carrola1/Ethan_Toy_RevB/Space_Toy_KiCAD/Space_Toy.kicad_pcb

## KiCad design Space_Toy_KiCAD/Space_Toy.kicad_pcb (2017-09-21)

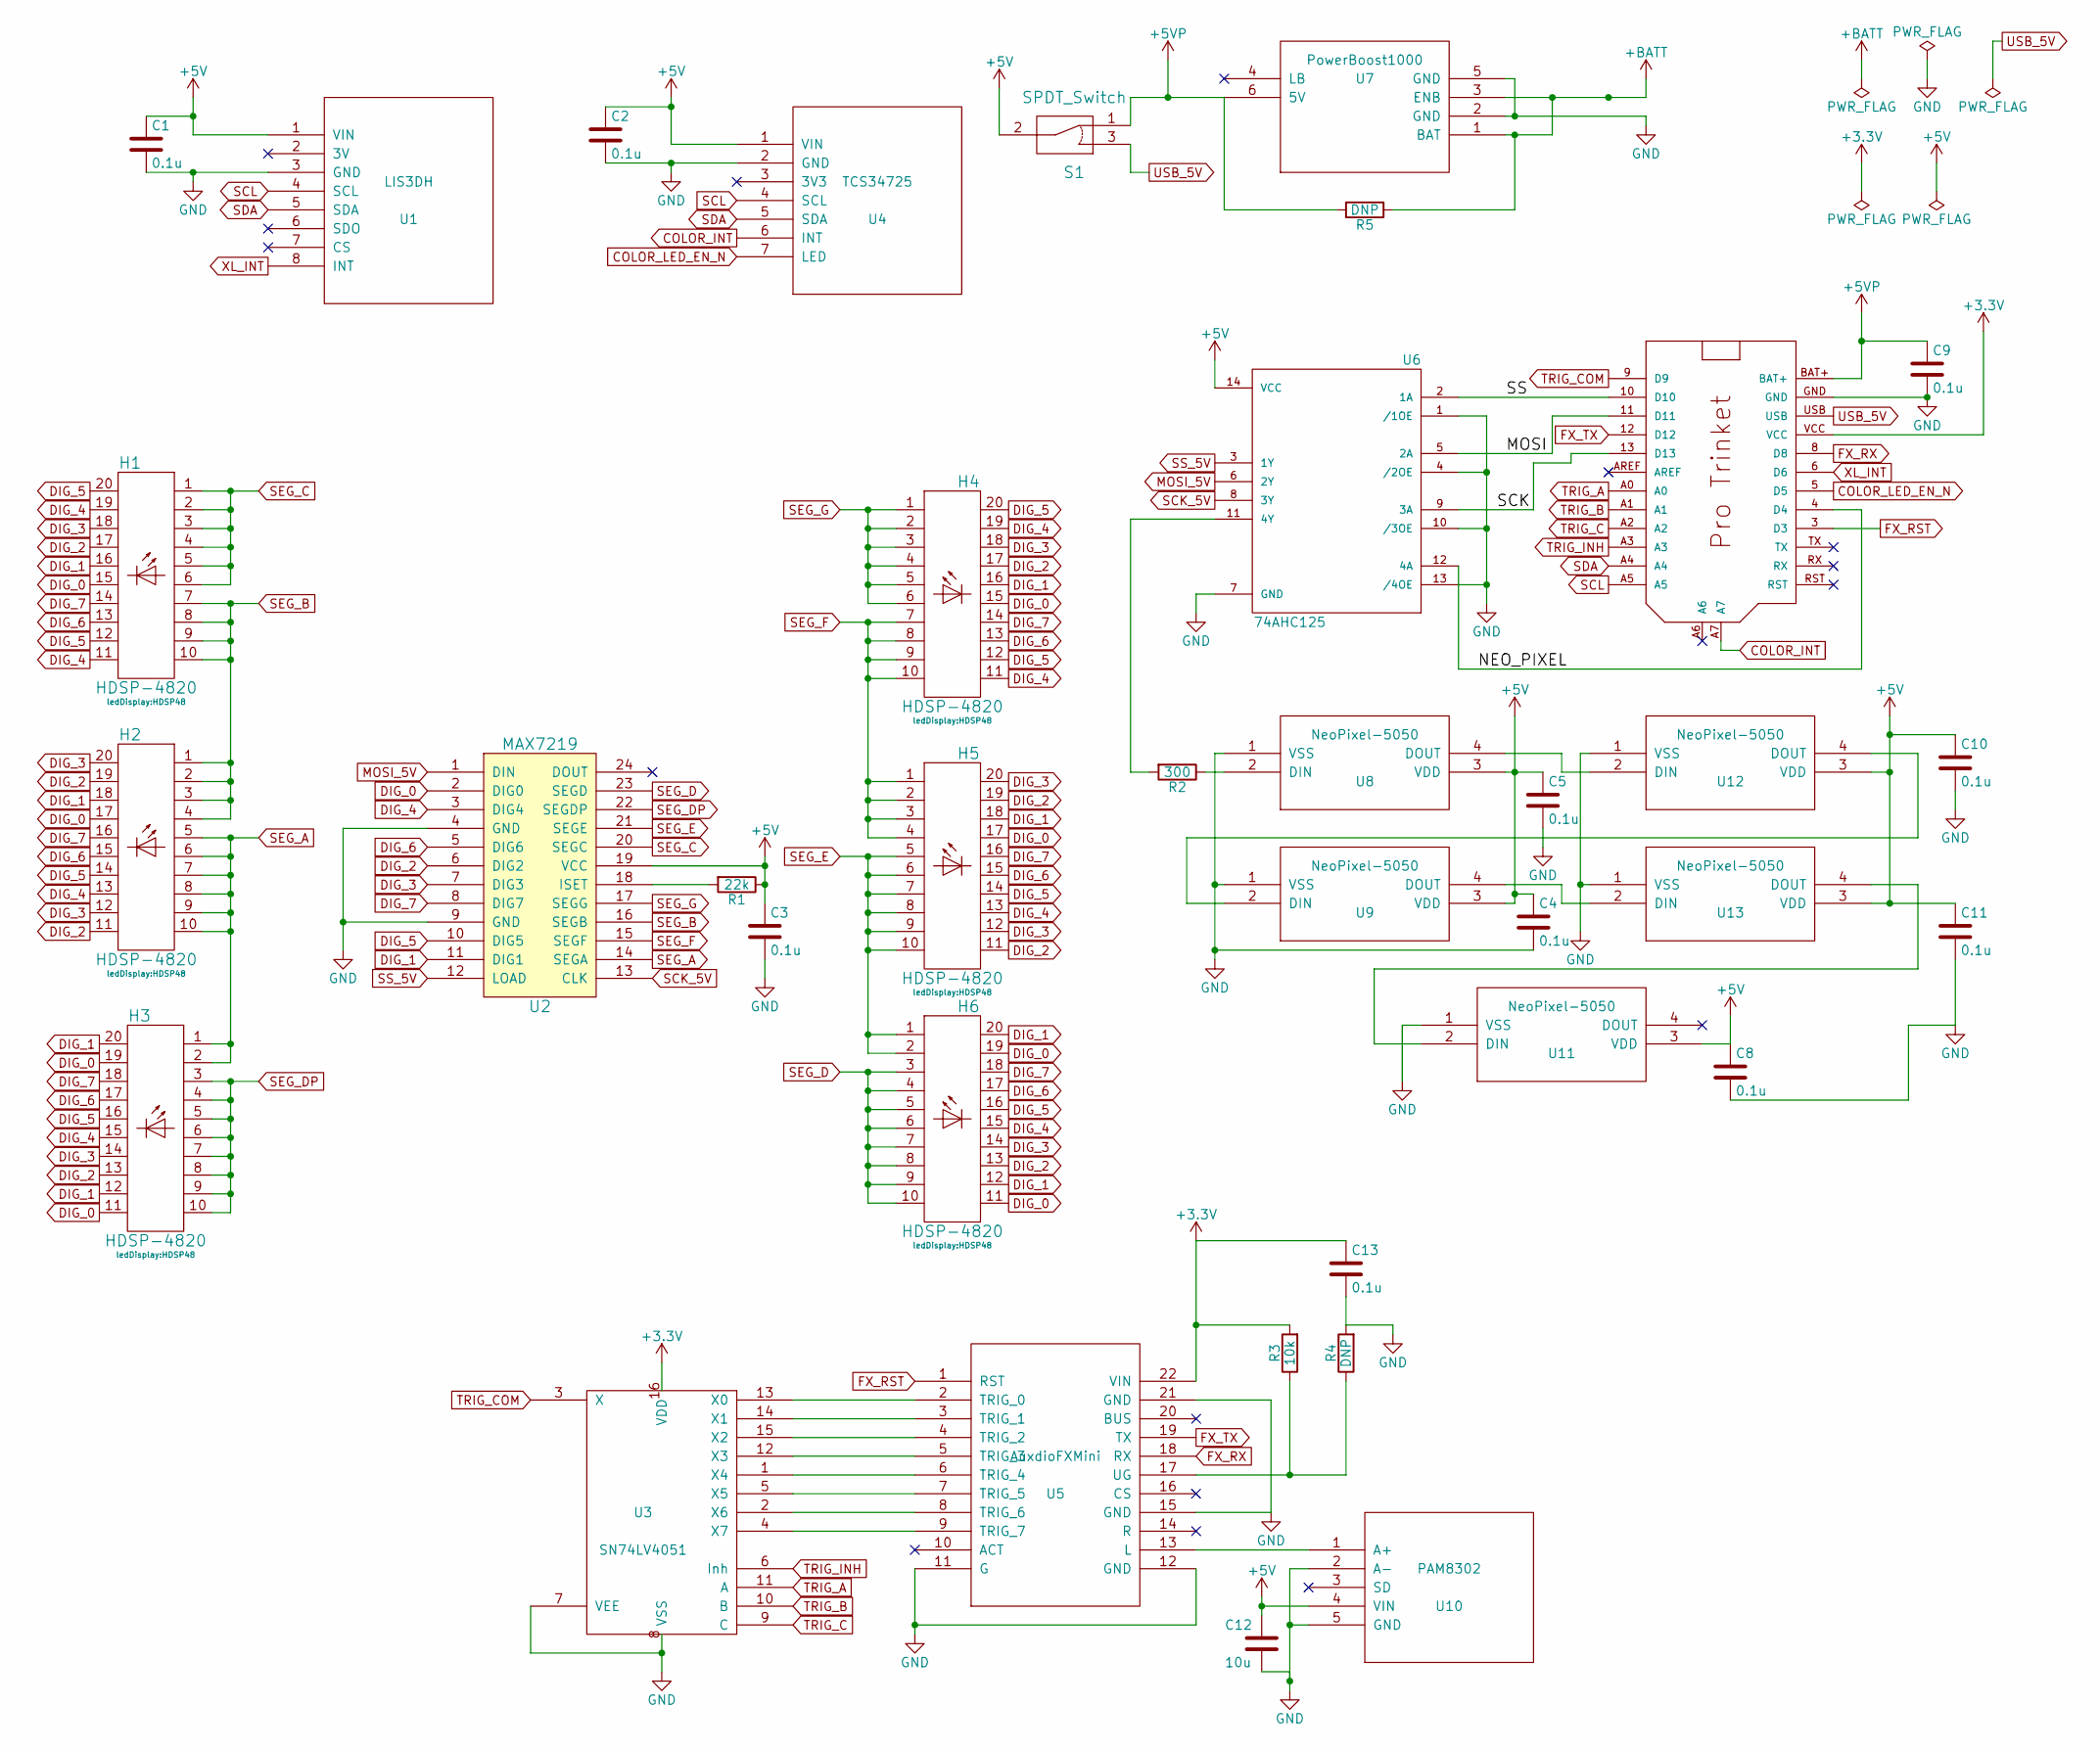
[picture p1: schematic Space_Toy.sch]

Parts:
C1, C2, C3, C4, C5, C8, C9, C10, C11, C13: 0.1u; C_0603_HandSoldering
C12: 10u; C_0603_HandSoldering
H1, H2, H3, H4, H5, H6: HDSP-4820; HDSP48
M1: PRO_TRINKET; PROTRINKET
R1: 22k; R_0805_HandSoldering
R2: 300; R_0805_HandSoldering
R3: 10k; R_0805_HandSoldering
R4, R5: DNP; R_0805_HandSoldering
S1: SPDT_Switch; SPDT
U1: LIS3DH
U2: MAX7219; DIP-24_W7.62mm_LongPads
U3: SN74LV4051; DIP-16_W7.62mm_LongPads
U4: TCS34725
U5: AuxdioFXMini; AudioFXMini
U6: 74AHC125; DIP-14_W7.62mm_LongPads
U7: PowerBoost1000
U8, U9, U11, U12, U13: NeoPixel-5050; NeoPixel5050
U10: PAM8302

Connections:
+3V3: C13.1, M1.VCC, R3.2, U3.16 (VDD), U5.22 (VIN)
+5V: C1.1, C2.1, C3.1, C4.1, C5.1, C8.1, C10.1, C11.1, C12.1, R1.1, S1.2, U1.1 (VIN), U2.19 (VCC), U4.1 (VIN), U6.14 (VCC), U8.3 (VDD), U9.3 (VDD), U10.4 (VIN), U11.3 (VDD), U12.3 (VDD), U13.3 (VDD)
+5VP: C9.1, M1.BAT+, R5.2, S1.1, U7.6 (5V)
+BATT: R5.1, U7.1 (BAT), U7.3 (ENB)
/MOSI: M1.11 (D11), U6.5 (2A)
/NEO_PIXEL: M1.4 (D4), U6.12 (4A)
/SCK: M1.13 (D13), U6.9 (3A)
/SS: M1.10 (D10), U6.2 (1A)
COLOR_INT: M1.A7, U4.6 (INT)
COLOR_LED_EN_N: M1.5 (D5), U4.7 (LED)
DIG_0: H1.15 (K), H2.17 (K), H3.11 (K), H3.19 (K), H4.15 (K), H5.17 (K), H6.11 (K), H6.19 (K), U2.2 (DIG0)
DIG_1: H1.16 (K), H2.18 (K), H3.12 (K), H3.20 (K), H4.16 (K), H5.18 (K), H6.12 (K), H6.20 (K), U2.11 (DIG1)
DIG_2: H1.17 (K), H2.11 (K), H2.19 (K), H3.13 (K), H4.17 (K), H5.11 (K), H5.19 (K), H6.13 (K), U2.6 (DIG2)
DIG_3: H1.18 (K), H2.12 (K), H2.20 (K), H3.14 (K), H4.18 (K), H5.12 (K), H5.20 (K), H6.14 (K), U2.7 (DIG3)
DIG_4: H1.11 (K), H1.19 (K), H2.13 (K), H3.15 (K), H4.11 (K), H4.19 (K), H5.13 (K), H6.15 (K), U2.3 (DIG4)
DIG_5: H1.12 (K), H1.20 (K), H2.14 (K), H3.16 (K), H4.12 (K), H4.20 (K), H5.14 (K), H6.16 (K), U2.10 (DIG5)
DIG_6: H1.13 (K), H2.15 (K), H3.17 (K), H4.13 (K), H5.15 (K), H6.17 (K), U2.5 (DIG6)
DIG_7: H1.14 (K), H2.16 (K), H3.18 (K), H4.14 (K), H5.16 (K), H6.18 (K), U2.8 (DIG7)
FX_RST: M1.3 (D3), U5.1 (RST)
FX_RX: M1.8 (D8), U5.18 (RX)
FX_TX: M1.12 (D12), U5.19 (TX)
GND: C1.2, C2.2, C3.2, C4.2, C5.2, C8.2, C9.2, C10.2, C11.2, C12.2, C13.2, M1.GND, R4.2, U1.3 (GND), U2.4 (GND), U2.9 (GND), U3.7 (VEE), U3.8 (VSS), U4.2 (GND), U5.11 (G), U5.12 (GND), U5.15 (GND), U5.21 (GND), U6.1 (/1OE), U6.4 (/2OE), U6.7 (GND), U6.10 (/3OE), U6.13 (/4OE), U7.2 (GND), U7.5 (GND), U8.1 (VSS), U9.1 (VSS), U10.2 (A-), U10.5 (GND), U11.1 (VSS), U12.1 (VSS), U13.1 (VSS)
MOSI_5V: U2.1 (DIN), U6.6 (2Y)
unnamed: R1.2, U2.18 (ISET)
unnamed: R2.1, U8.2 (DIN)
unnamed: R2.2, U6.11 (4Y)
unnamed: R3.1, R4.1, U5.17 (UG)
unnamed: U3.1 (X4), U5.6 (TRIG_4)
unnamed: U3.2 (X6), U5.8 (TRIG_6)
unnamed: U3.4 (X7), U5.9 (TRIG_7)
unnamed: U3.5 (X5), U5.7 (TRIG_5)
unnamed: U3.12 (X3), U5.5 (TRIG_3)
unnamed: U3.13 (X0), U5.2 (TRIG_0)
unnamed: U3.14 (X1), U5.3 (TRIG_1)
unnamed: U3.15 (X2), U5.4 (TRIG_2)
unnamed: U5.13 (L), U10.1 (A+)
unnamed: U11.2 (DIN), U13.4 (DOUT)
unnamed: U8.4 (DOUT), U12.2 (DIN)
unnamed: U9.2 (DIN), U12.4 (DOUT)
unnamed: U9.4 (DOUT), U13.2 (DIN)
SCK_5V: U2.13 (CLK), U6.8 (3Y)
SCL: M1.A5, U1.4 (SCL), U4.4 (SCL)
SDA: M1.A4, U1.5 (SDA), U4.5 (SDA)
SEG_A: H2.5 (A), H2.6 (A), H2.7 (A), H2.8 (A), H2.9 (A), H2.10 (A), H3.1 (A), H3.2 (A), U2.14 (SEGA)
SEG_B: H1.7 (A), H1.8 (A), H1.9 (A), H1.10 (A), H2.1 (A), H2.2 (A), H2.3 (A), H2.4 (A), U2.16 (SEGB)
SEG_C: H1.1 (A), H1.2 (A), H1.3 (A), H1.4 (A), H1.5 (A), H1.6 (A), U2.20 (SEGC)
SEG_D: H6.3 (A), H6.4 (A), H6.5 (A), H6.6 (A), H6.7 (A), H6.8 (A), H6.9 (A), H6.10 (A), U2.23 (SEGD)
SEG_DP: H3.3 (A), H3.4 (A), H3.5 (A), H3.6 (A), H3.7 (A), H3.8 (A), H3.9 (A), H3.10 (A), U2.22 (SEGDP)
SEG_E: H5.5 (A), H5.6 (A), H5.7 (A), H5.8 (A), H5.9 (A), H5.10 (A), H6.1 (A), H6.2 (A), U2.21 (SEGE)
SEG_F: H4.7 (A), H4.8 (A), H4.9 (A), H4.10 (A), H5.1 (A), H5.2 (A), H5.3 (A), H5.4 (A), U2.15 (SEGF)
SEG_G: H4.1 (A), H4.2 (A), H4.3 (A), H4.4 (A), H4.5 (A), H4.6 (A), U2.17 (SEGG)
SS_5V: U2.12 (LOAD), U6.3 (1Y)
TRIG_A: M1.A0, U3.11 (A)
TRIG_B: M1.A1, U3.10 (B)
TRIG_C: M1.A2, U3.9 (C)
TRIG_COM: M1.9 (D9), U3.3 (X)
TRIG_INH: M1.A3, U3.6 (Inh)
USB_5V: M1.USB, S1.3
XL_INT: M1.6 (D6), U1.8 (INT)

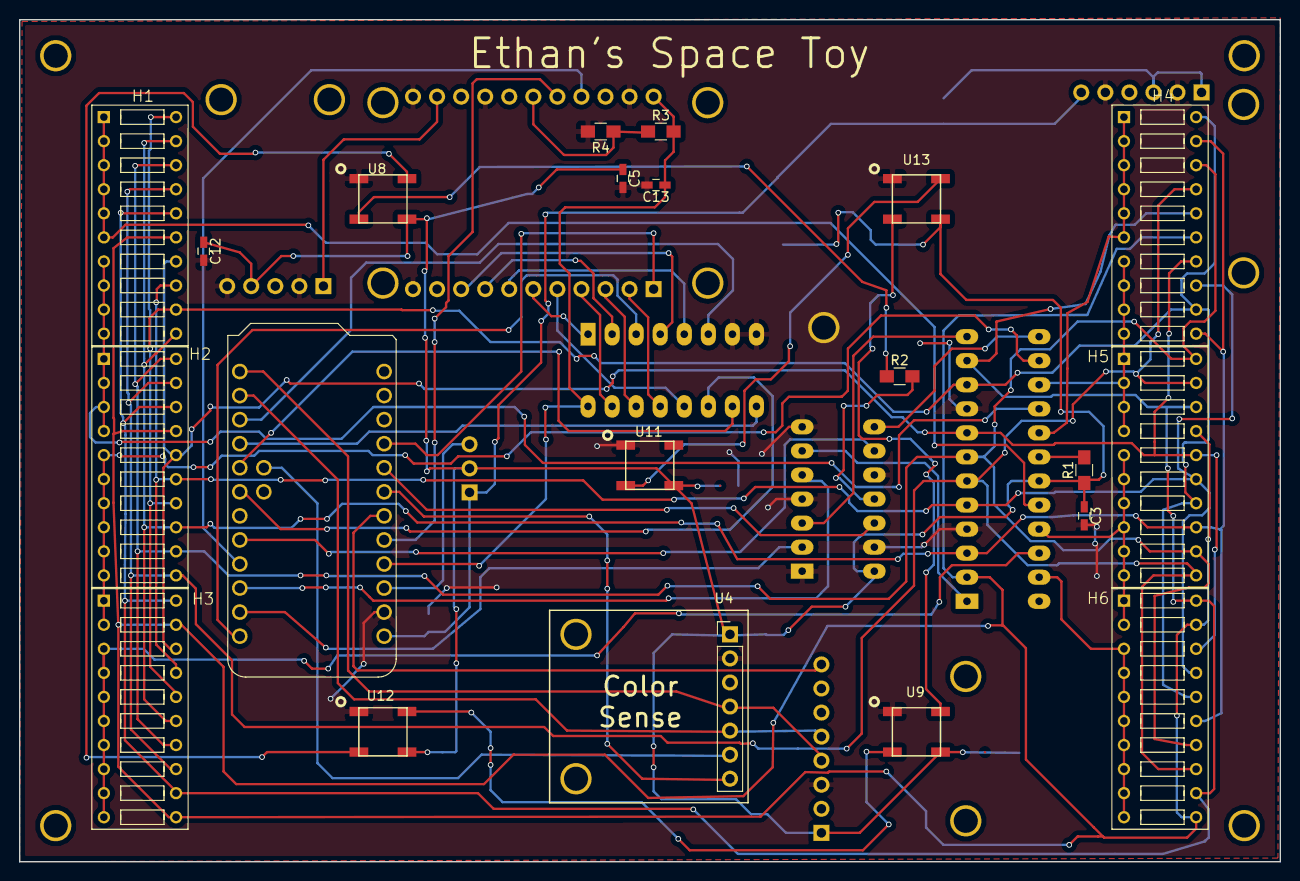
[picture p2: board Space_Toy.kicad_pcb from above]

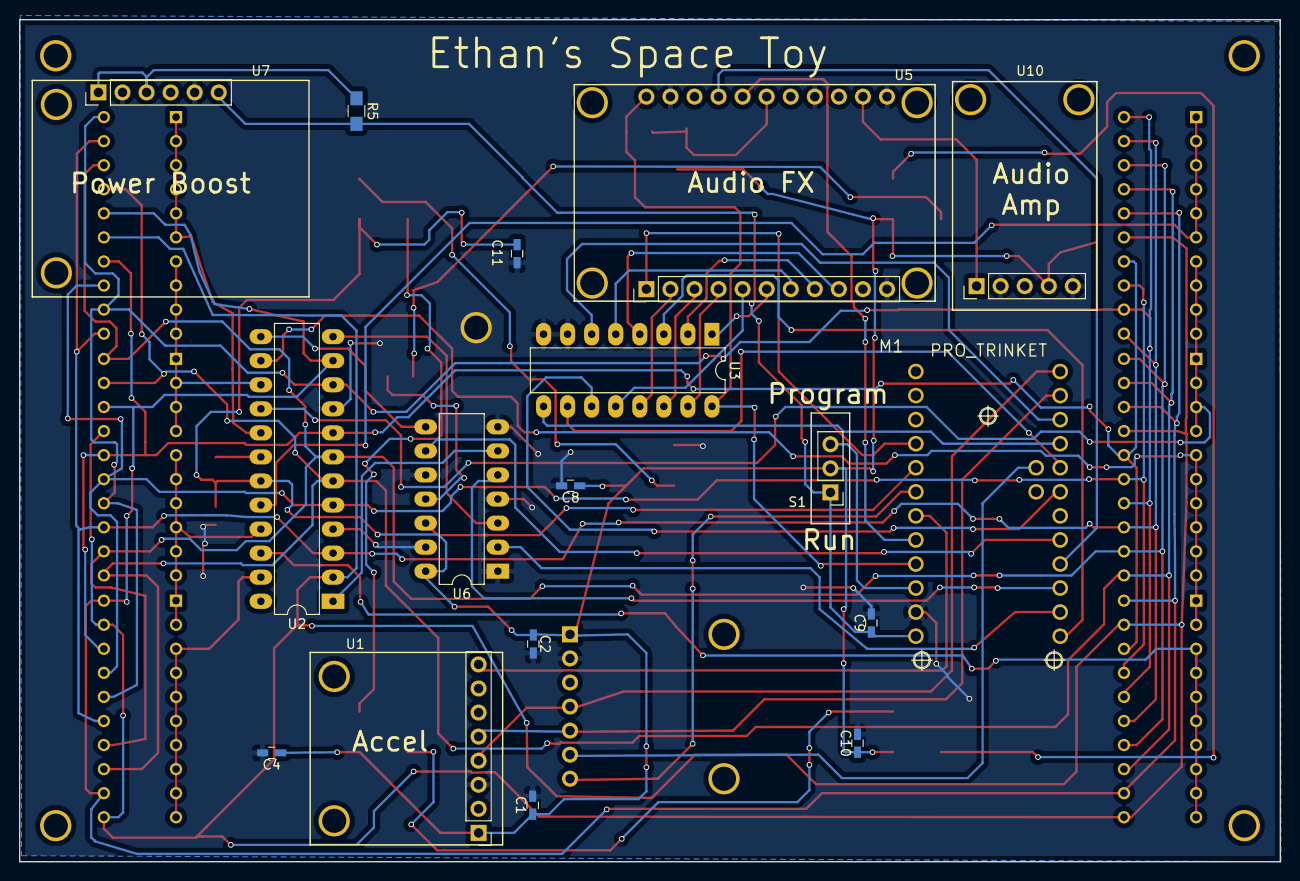
[picture p3: board Space_Toy.kicad_pcb from below]

Board: 2 copper layers, 133.1 x 88.9 mm, 37 parts (17 on the bottom side), 59 nets.
