carrola1/Ethan_Toy_RevB/(commit log)

2017-08-20 Added audio, accelerometer, LED support
2017-09-21 Fully functional
    [Space_Toy-B.Cu.gbr, Space_Toy-B.Mask.gbr, Space_Toy-B.Paste.gbr, Space_Toy-B.SilkS.gbr, Space_Toy-Edge.Cuts.gbr, Space_Toy-F.Cu.gbr, Space_Toy-F.Mask.gbr, Space_Toy-F.Paste.gbr]
